zarzak12/PilotSpa/(notices)

Notices in the files:
README.MD:
License: MIT
